malik019/iot-project/model3d/deans-t-plug-connectors-male-and-female-1.snapshot.5/ULTRA-PLUG.png

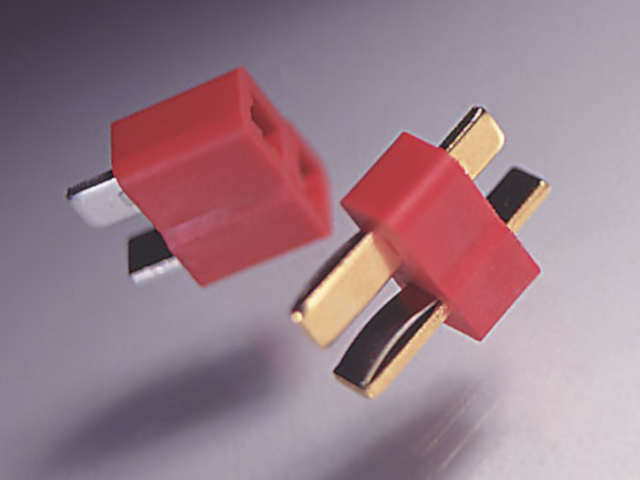
model3d/deans-t-plug-connectors-male-and-female-1.snapshot.5/ULTRA-PLUG.png
