malik019/iot-project/model3d/deans-t-plug-connectors-male-and-female-1.snapshot.5/Dins T-Plug.png

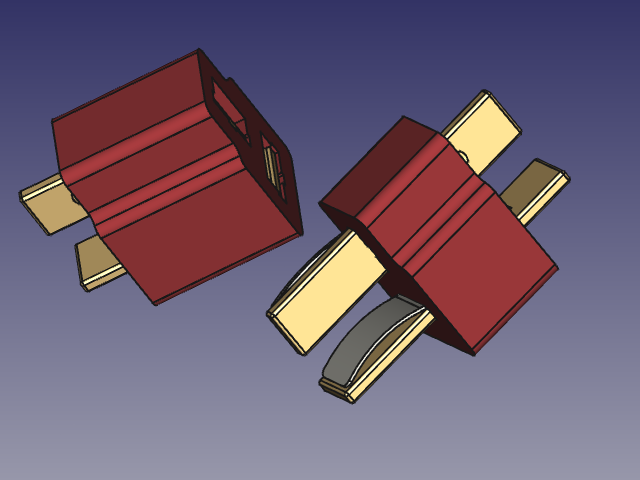
model3d/deans-t-plug-connectors-male-and-female-1.snapshot.5/Dins T-Plug.png
