malik019/iot-project/model3d/deans-t-plug-connectors-male-and-female-1.snapshot.5/T-Plug male - W.S Deans Co. Est. 1957.step

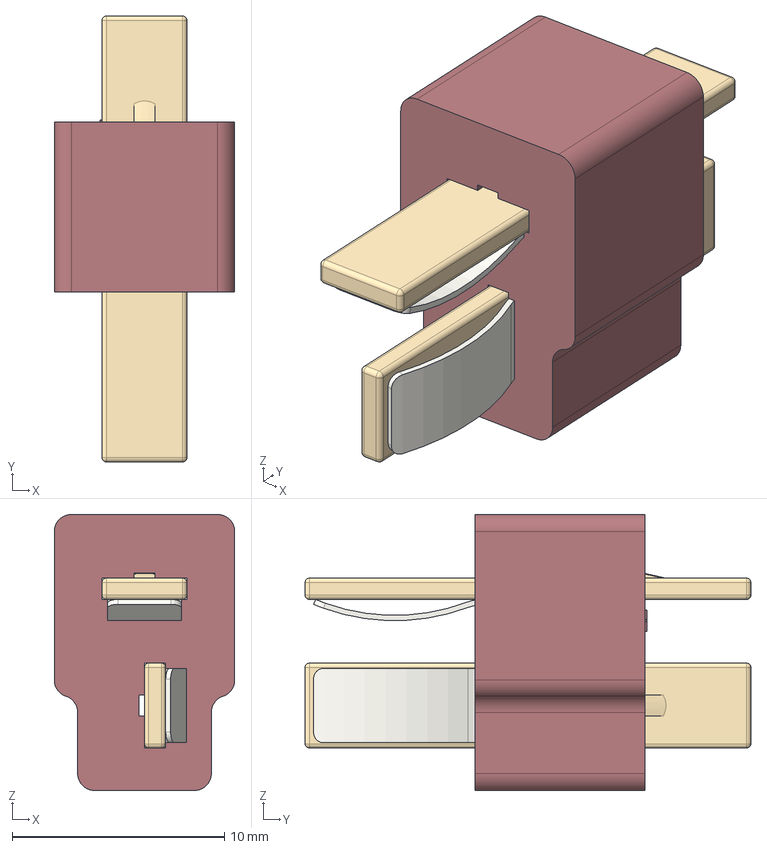
[picture p32: CAD file, 2026-05-25]
model3d/deans-t-plug-connectors-male-and-female-1.snapshot.5/T-Plug male - W.S Deans Co. Est. 1957.step
8.50 x 21.0 x 13.0 mm
