malik019/iot-project/model3d/WS2812-2020--3DModel-STEP-1.STEP

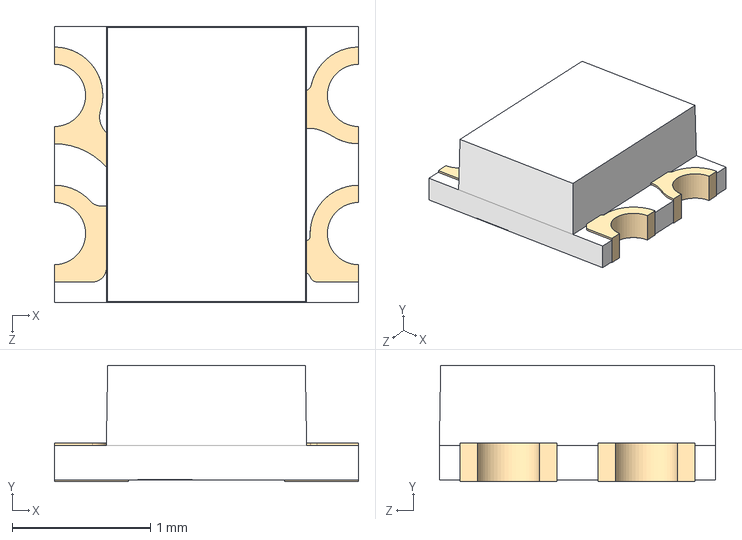
[picture p33: CAD file, 2026-05-25]
model3d/WS2812-2020--3DModel-STEP-1.STEP
2.20 x 0.84 x 2.00 mm
