malik019/iot-project/TP5100/TP5100.step

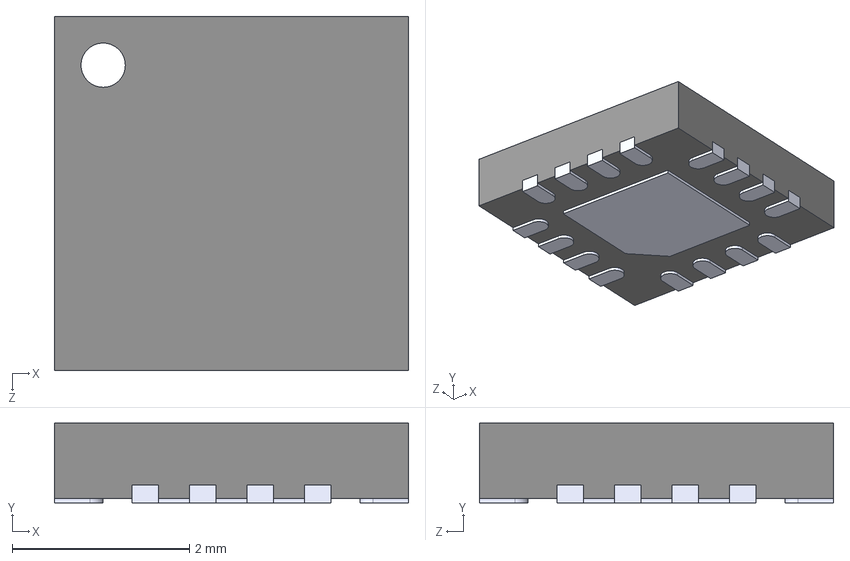
[picture p34: CAD file, 2026-05-25]
TP5100/TP5100.step
4.00 x 0.9 x 4.00 mm
