malik019/iot-project/model3d/deans-t-plug-connectors-male-and-female-1.snapshot.5/T-Plug female - W.S Deans Co. Est. 1957.step

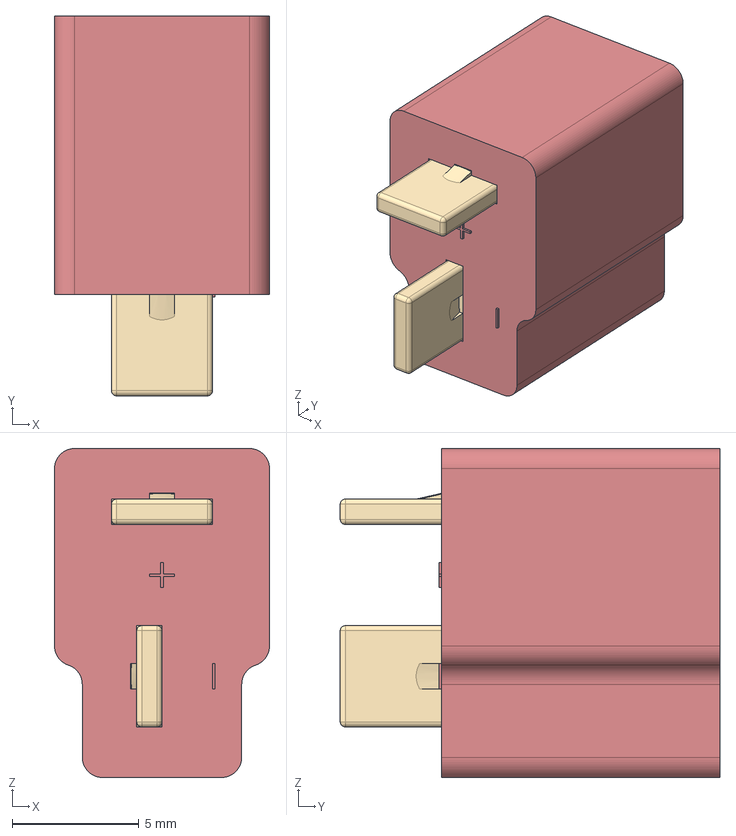
[picture p35: CAD file, 2026-05-25]
model3d/deans-t-plug-connectors-male-and-female-1.snapshot.5/T-Plug female - W.S Deans Co. Est. 1957.step
8.50 x 15.0 x 13.0 mm
