malik019/iot-project/model3d/TS-1187A-B-A-B--3DModel-STEP-56544.STEP

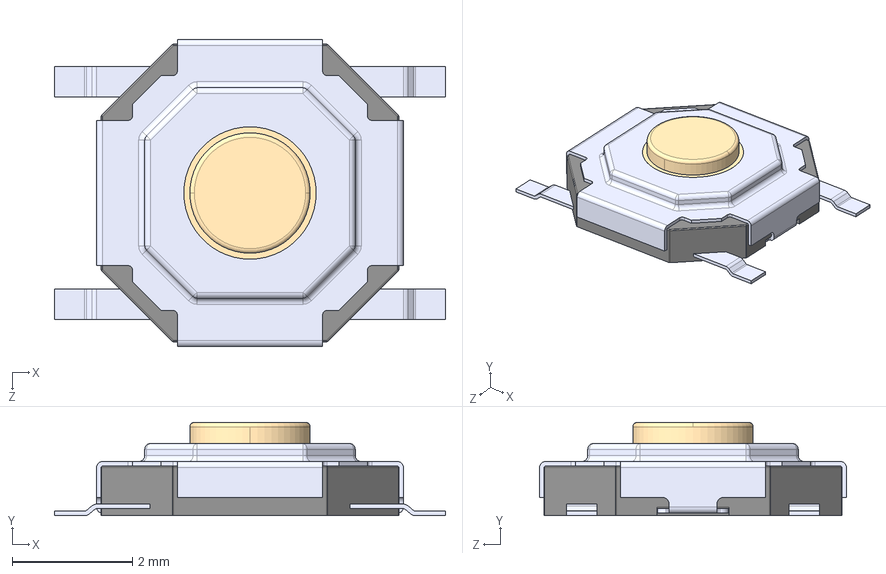
[picture p36: CAD file, 2026-05-25]
model3d/TS-1187A-B-A-B--3DModel-STEP-56544.STEP
6.50 x 1.55 x 5.10 mm
