malik019/iot-project/model3d/ESP32-C6-MINI-1-H4.STEP

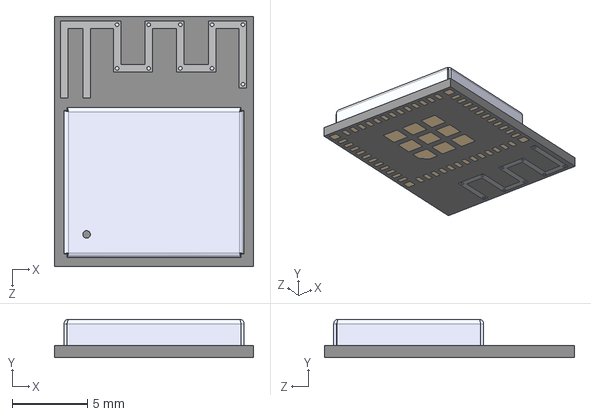
[picture p37: CAD file, 2026-05-25]
model3d/ESP32-C6-MINI-1-H4.STEP
13.2 x 2.55 x 16.6 mm
