malik019/iot-project/robot.kicad_pcb

## KiCad design robot.kicad_pcb (2026-05-28)

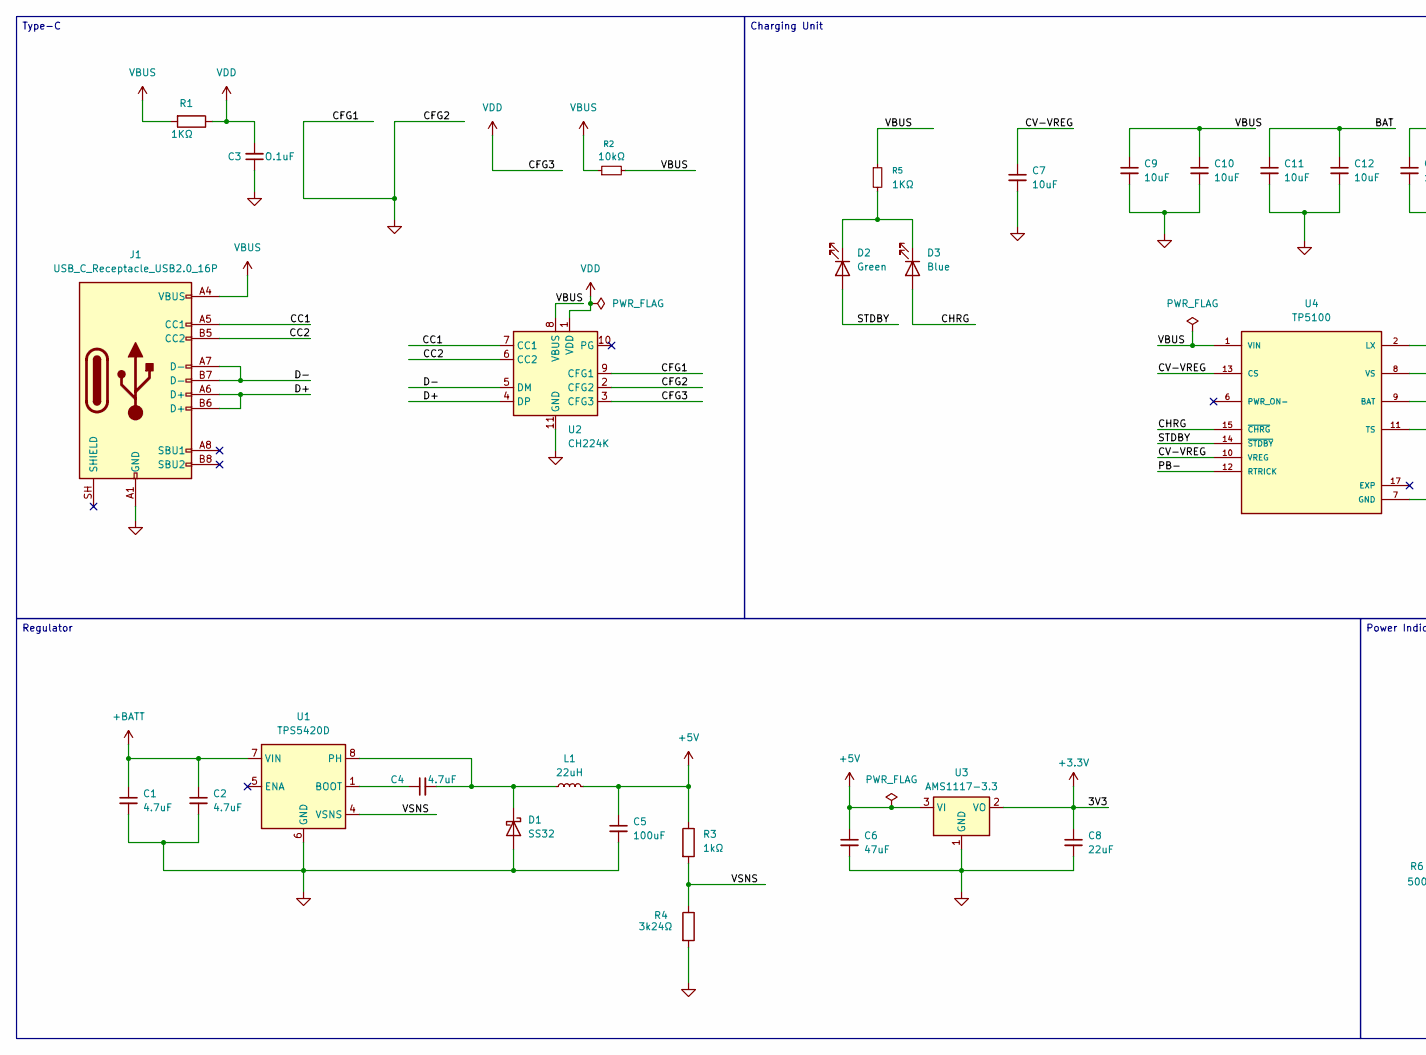
[picture p38: schematic robot.kicad_sch, Power, part in row 1, column 1]

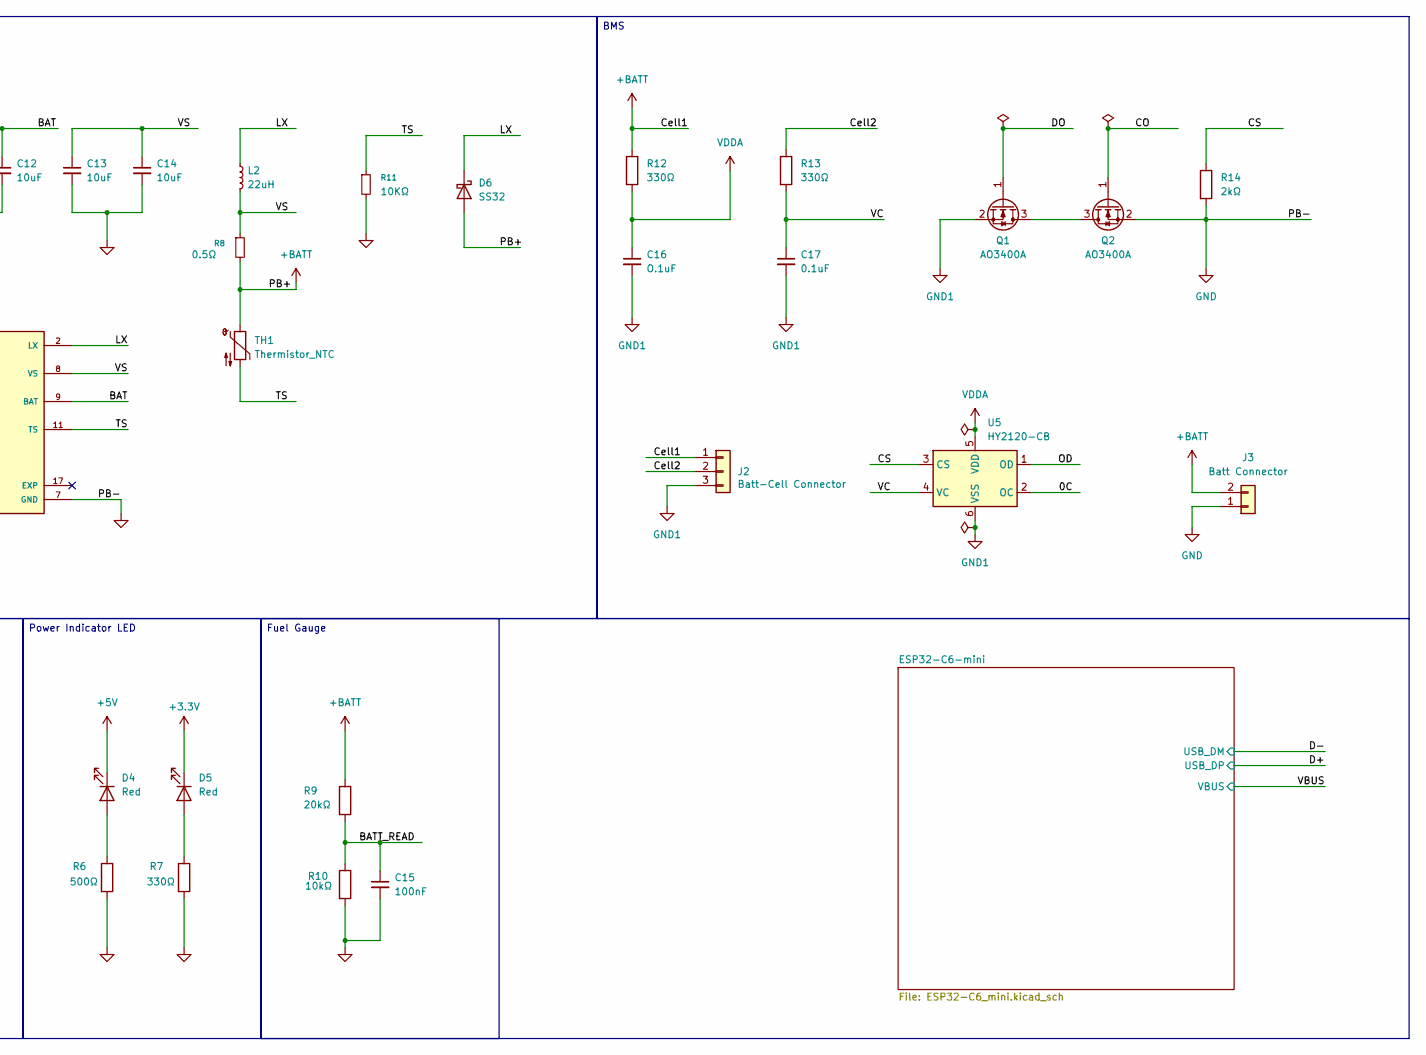
[picture p39: schematic robot.kicad_sch, Power, part in row 1, column 2]

Parts:
C1, C2, C4: 4.7uF; C_0805_2012Metric
C3, C16: O.1uF; C_0805_2012Metric
C5: 100uF; C_0805_2012Metric
C6: 47uF; C_0805_2012Metric
C7, C9, C10, C11, C12, C13, C14: 10uF; C_0805_2012Metric
C8: 22uF; C_0805_2012Metric
C15: 100nF; C_0805_2012Metric
C17: 0.1uF; C_0805_2012Metric
D1, D6: SS32; D_SMA
D2: Green; LED_0805_2012Metric
D3: Blue; LED_0805_2012Metric
D4, D5: Red; LED_0805_2012Metric
J1: USB_C_Receptacle_USB2.0_16P; USB_C_Receptacle_HRO_TYPE-C-31-M-12
J2: Batt-Cell Connector; JST_XH_B3B-XH-A_1x03_P2.50mm_Vertical
J3: Batt Connector; DEANS
L1, L2: 22uH; L_Changjiang_FXL0630
Q1, Q2: AO3400A; SOT-23
R1, R5: 1KΩ; R_0805_2012Metric
R2, R10: 10kΩ; R_0805_2012Metric
R3: 1kΩ; R_0805_2012Metric
R4: 3k24Ω; R_0805_2012Metric
R6: 500Ω; R_0805_2012Metric
R7, R12, R13: 330Ω; R_0805_2012Metric
R8: 0.5Ω; R_0805_2012Metric
R9: 20kΩ; R_0805_2012Metric
R11: 10KΩ; R_0805_2012Metric
R14: 2kΩ; R_0805_2012Metric
TH1: Thermistor_NTC; R_0805_2012Metric
U1: TPS5420D; SOIC-8_3.9x4.9mm_P1.27mm
U2: CH224K; SSOP-10-1EP_3.9x4.9mm_P1mm_EP2.1x3.3mm
U3: AMS1117-3.3; SOT-223-3_TabPin2
U4: TP5100; QFN65P400X400X90-17N; PARTREV 2.3
U5: HY2120-CB; SOT-23-6

Connections:
+3.3V: C8.1, D5.1 (K), U3.2 (VO); also elsewhere on the board
+5V: C5.1, C6.1, D4.1 (K), L1.2, R3.1, U3.3 (VI); also elsewhere on the board
+BATT: C1.1, C2.1, D6.2 (A), J2.1, J3.2, R8.2, R9.1, R12.1, TH1.1, U1.7 (VIN); also elsewhere on the board
/0C: U5.2 (OC)
/BAT: C11.1, C12.1, U4.9 (BAT)
/BATT_READ: C15.1, R9.2, R10.1
/CC1: J1.A5 (CC1), U2.7 (CC1)
/CC2: J1.B5 (CC2), U2.6 (CC2)
/CHRG: D3.2 (A), U4.15 (~CHRG)
/CO: Q2.1 (G)
/CS: R14.1, U5.3 (CS)
/CV-VREG: C7.1, U4.10 (VREG), U4.13 (CS)
/Cell2: J2.2, R13.1
/D+: J1.A6 (D+), J1.B6 (D+), U2.4 (DP); also elsewhere on the board
/D-: J1.A7 (D-), J1.B7 (D-), U2.5 (DM); also elsewhere on the board
/DO: Q1.1 (G)
/LX: D6.1 (K), L2.1, U4.2 (LX), U4.3 (LX)
/OD: U5.1 (OD)
/STDBY: D2.2 (A), U4.14 (~STDBY)
/TS: R11.1, TH1.2, U4.11 (TS)
/VC: C17.1, R13.2, U5.4 (VC)
/VS: C13.1, C14.1, L2.2, R8.1, U4.8 (VS)
/VSNS: R3.2, R4.1, U1.4 (VSNS)
GND: C1.2, C2.2, C3.1, C5.2, C6.2, C7.2, C8.2, C9.2, C10.2, C11.2, C12.2, C13.2, C14.2, C15.2, D1.2 (A), J1.A1 (GND), J1.A12 (GND), J1.B1 (GND), J1.B12 (GND), J3.1, Q2.2 (S), R4.2, R6.2, R7.2, R10.2, R11.2, R14.2, U1.6 (GND), U2.2 (CFG2), U2.9 (CFG1), U2.11 (GND), U3.1 (GND), U4.7 (GND), U4.12 (RTRICK); also elsewhere on the board
GND1: C16.2, C17.2, J2.3, Q1.2 (S), U5.6 (VSS)
unnamed: C4.2, D1.1 (K), L1.1, U1.8 (PH)
unnamed: D2.1 (K), D3.1 (K), R5.2
unnamed: D4.2 (A), R6.1
unnamed: D5.2 (A), R7.1
unnamed: Q1.3 (D), Q2.3 (D)
unnamed: C4.1, U1.1 (BOOT)
VBUS: C9.1, C10.1, J1.A4 (VBUS), J1.A9 (VBUS), J1.B4 (VBUS), J1.B9 (VBUS), R1.2, R2.1, R2.2, R5.1, U2.8 (VBUS), U4.1 (VIN), U4.4 (VIN), U4.5 (VIN), U4.16 (VIN); also elsewhere on the board
VDD: C3.2, R1.1, U2.1 (VDD), U2.3 (CFG3)
VDDA: C16.1, R12.2, U5.5 (VDD)

Notes on the sheet:
Charging Unit
Type-C
BMS
Fuel Gauge
Power Indicator LED
Regulator

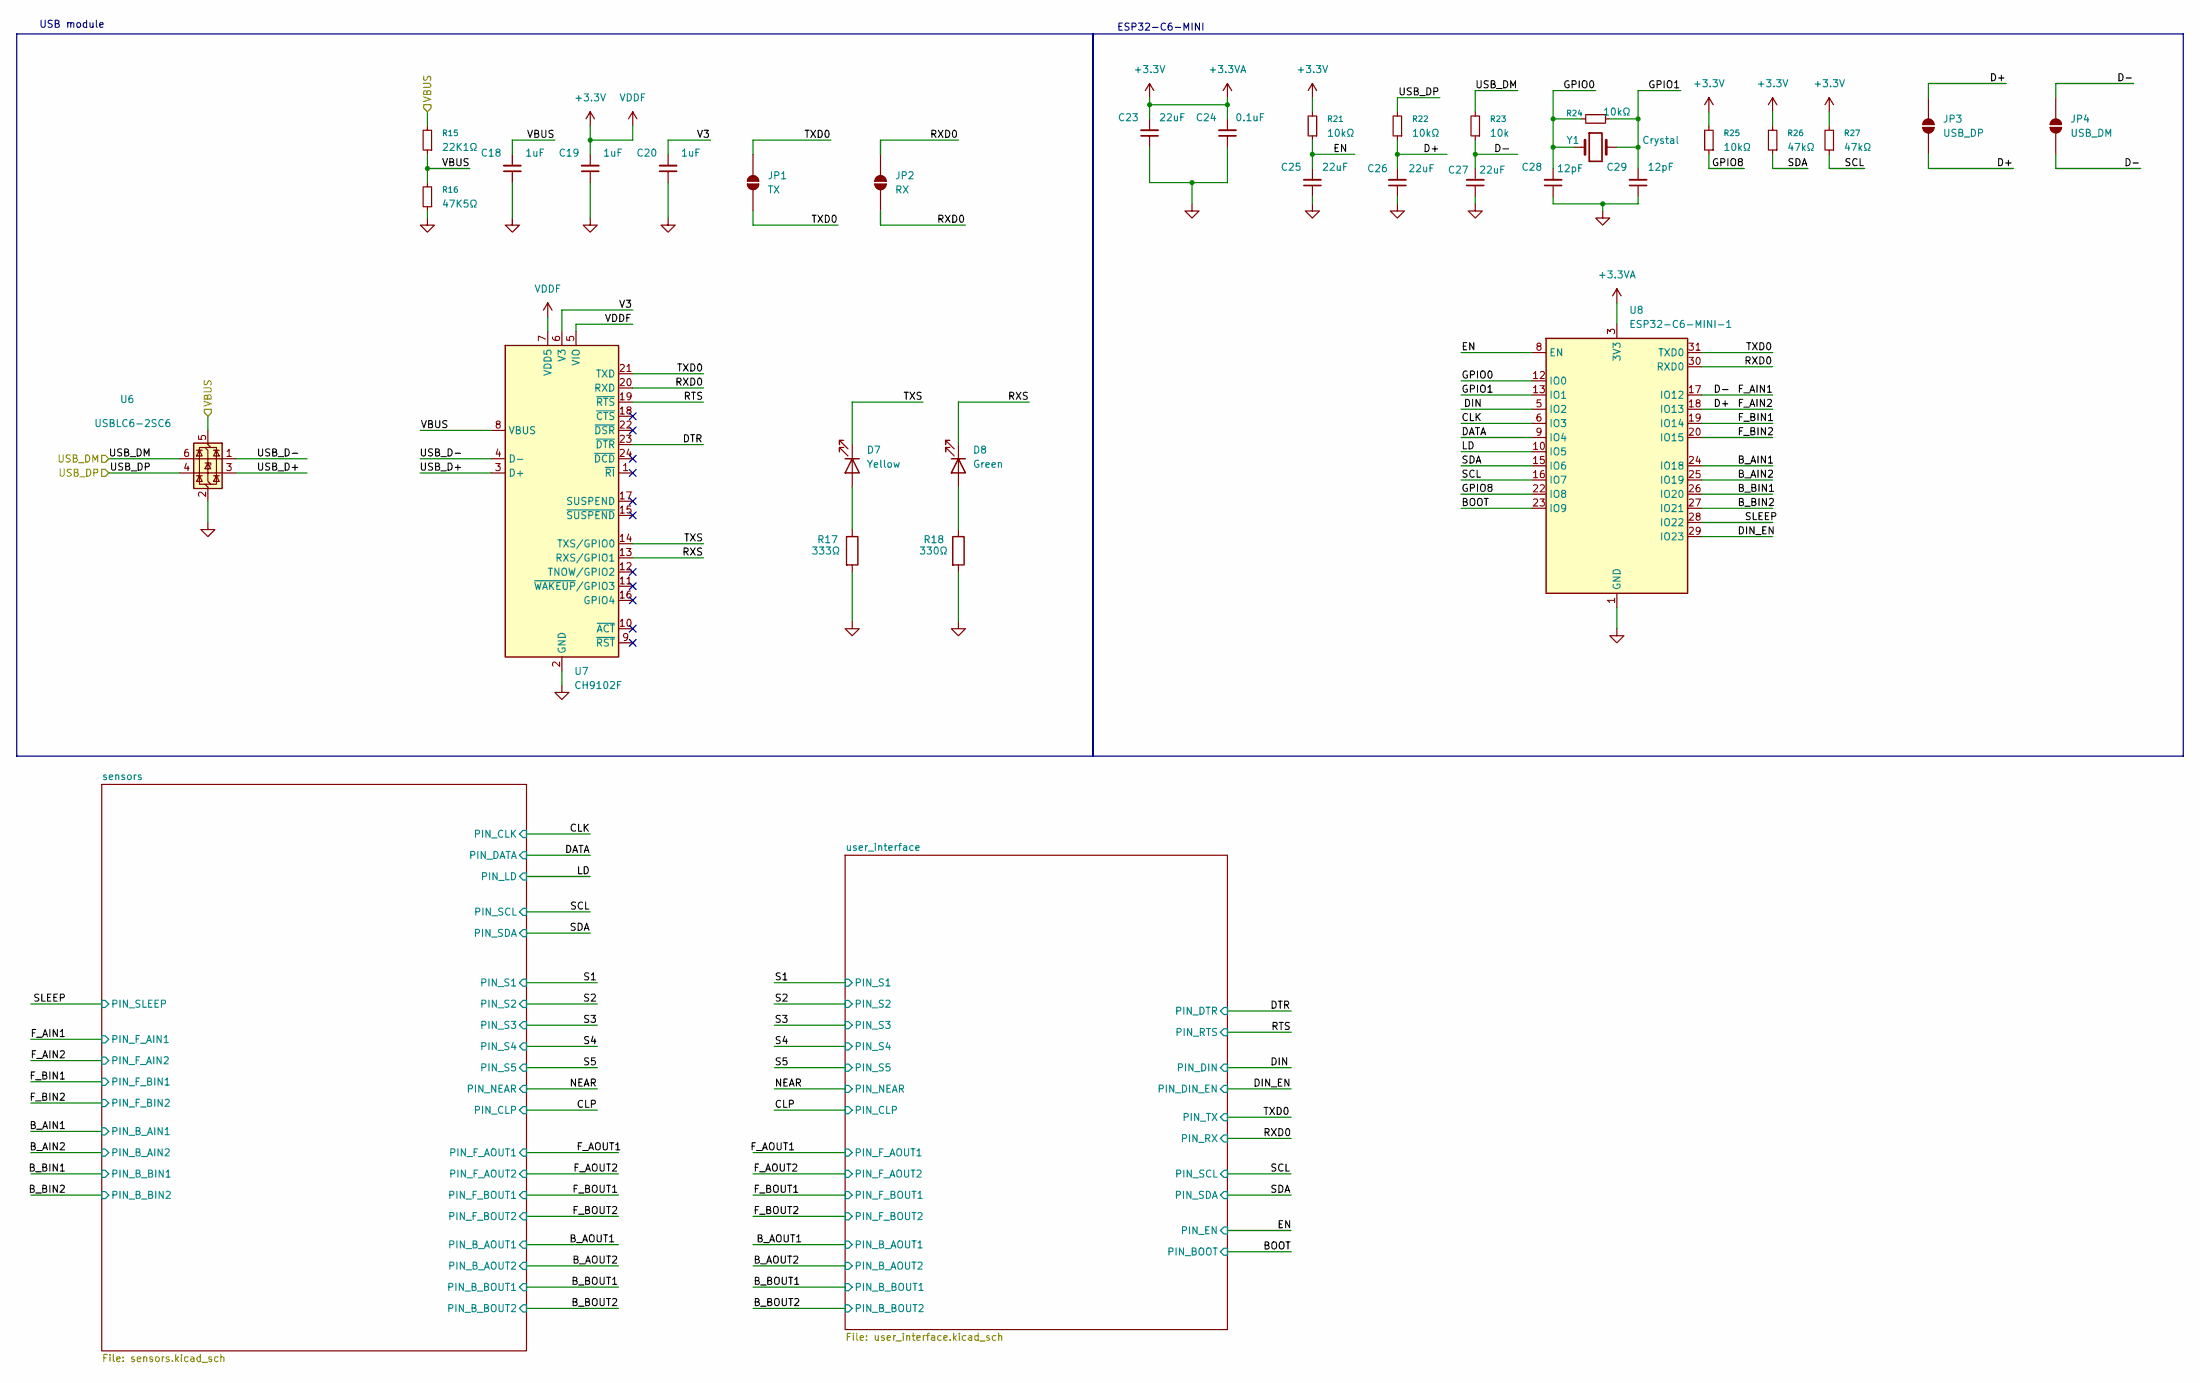
[picture p40: schematic ESP32-C6_mini.kicad_sch, ESP32-C6-MINI]

Parts:
C18, C19, C20: 1uF; C_0805_2012Metric
C23, C25, C26, C27: 22uF; C_0805_2012Metric
C24: 0.1uF; C_0805_2012Metric
C28, C29: 12pF; C_0805_2012Metric
D7: Yellow; LED_0805_2012Metric
D8: Green; LED_0805_2012Metric
JP1: TX; SolderJumper-2_P1.3mm_Open_TrianglePad1.0x1.5mm
JP2: RX; SolderJumper-2_P1.3mm_Open_TrianglePad1.0x1.5mm
JP3: USB_DP; SolderJumper-2_P1.3mm_Open_TrianglePad1.0x1.5mm
JP4: USB_DM; SolderJumper-2_P1.3mm_Open_TrianglePad1.0x1.5mm
R15: 22K1Ω; R_0805_2012Metric
R16: 47K5Ω; R_0805_2012Metric
R17: 333Ω; R_0805_2012Metric
R18: 330Ω; R_0805_2012Metric
R21, R22, R24, R25: 10kΩ; R_0805_2012Metric
R23: 10k; R_0805_2012Metric
R26, R27: 47kΩ; R_0805_2012Metric
U6: USBLC6-2SC6; SOT-23-6
U7: CH9102F; QFN-24-1EP_4x4mm_P0.5mm_EP2.6x2.6mm
U8: ESP32-C6-MINI-1
Y1: Crystal; Crystal_SMD_3215-2Pin_3.2x1.5mm

Connections:
+3.3V: C19.2, C23.2, C24.2, R21.2, R25.2, R26.2, R27.2, U7.5 (VIO), U7.7 (VDD5), U8.3 (3V3); also elsewhere on the board
/D+: R22.2, U6.4 (I/O2); also elsewhere on the board
/D-: R23.2, U6.6 (I/O1); also elsewhere on the board
/ESP32-C6-mini/BOOT: U8.23 (IO9); also elsewhere on the board
/ESP32-C6-mini/B_AIN1: U8.24 (IO18); also elsewhere on the board
/ESP32-C6-mini/B_AIN2: U8.25 (IO19); also elsewhere on the board
/ESP32-C6-mini/B_BIN1: U8.26 (IO20); also elsewhere on the board
/ESP32-C6-mini/B_BIN2: U8.27 (IO21); also elsewhere on the board
/ESP32-C6-mini/CLK: U8.6 (IO3); also elsewhere on the board
/ESP32-C6-mini/D+: C26.2, JP3.1 (A), JP3.2 (B), R22.1, U8.18 (IO13); also elsewhere on the board
/ESP32-C6-mini/D-: C27.2, JP4.1 (A), JP4.2 (B), R23.1, U8.17 (IO12); also elsewhere on the board
/ESP32-C6-mini/DATA: U8.9 (IO4); also elsewhere on the board
/ESP32-C6-mini/DIN: U8.5 (IO2); also elsewhere on the board
/ESP32-C6-mini/DIN_EN: U8.29 (IO23); also elsewhere on the board
/ESP32-C6-mini/DTR: U7.23 (~DTR); also elsewhere on the board
/ESP32-C6-mini/EN: C25.2, R21.1, U8.8 (EN); also elsewhere on the board
/ESP32-C6-mini/F_BIN1: U8.19 (IO14); also elsewhere on the board
/ESP32-C6-mini/F_BIN2: U8.20 (IO15); also elsewhere on the board
/ESP32-C6-mini/GPIO0: C28.2, R24.2, U8.12 (IO0), Y1.1
/ESP32-C6-mini/GPIO1: C29.2, R24.1, U8.13 (IO1), Y1.2
/ESP32-C6-mini/GPIO8: R25.1, U8.22 (IO8)
/ESP32-C6-mini/LD: U8.10 (IO5); also elsewhere on the board
/ESP32-C6-mini/RTS: U7.19 (~RTS); also elsewhere on the board
/ESP32-C6-mini/RXD0: JP2.1 (A), JP2.2 (B), U7.20 (RXD), U8.30 (RXD0); also elsewhere on the board
/ESP32-C6-mini/RXS: D8.1 (K), U7.13 (RXS/GPIO1)
/ESP32-C6-mini/SCL: R27.1, U8.16 (IO7); also elsewhere on the board
/ESP32-C6-mini/SDA: R26.1, U8.15 (IO6); also elsewhere on the board
/ESP32-C6-mini/SLEEP: U8.28 (IO22); also elsewhere on the board
/ESP32-C6-mini/TXD0: JP1.1 (A), JP1.2 (B), U7.21 (TXD), U8.31 (TXD0); also elsewhere on the board
/ESP32-C6-mini/TXS: D7.1 (K), U7.14 (TXS/GPIO0)
/ESP32-C6-mini/USB_D+: U6.3 (I/O2), U7.3 (D+)
/ESP32-C6-mini/USB_D-: U6.1 (I/O1), U7.4 (D-)
/ESP32-C6-mini/V3: C20.2, U7.6 (V3)
GND: C18.1, C19.1, C20.1, C23.1, C24.1, C25.1, C26.1, C27.1, C28.1, C29.1, R16.1, R17.2, R18.2, U6.2 (GND), U7.2 (GND), U7.25 (GND), U8.1 (GND), U8.2 (GND), U8.11 (GND), U8.14 (GND), U8.36 (GND), U8.37 (GND), U8.38 (GND), U8.39 (GND), U8.40 (GND), U8.41 (GND), U8.42 (GND), U8.43 (GND), U8.44 (GND), U8.45 (GND), U8.46 (GND), U8.47 (GND), U8.48 (GND), U8.49 (GND), U8.50 (GND), U8.51 (GND), U8.52 (GND), U8.53 (GND); also elsewhere on the board
unnamed: D7.2 (A), R17.1
unnamed: D8.2 (A), R18.1
VBUS: C18.2, R15.1, R15.2, R16.2, U6.5 (VBUS), U7.8 (VBUS); also elsewhere on the board

Notes on the sheet:
USB module
ESP32-C6-MINI

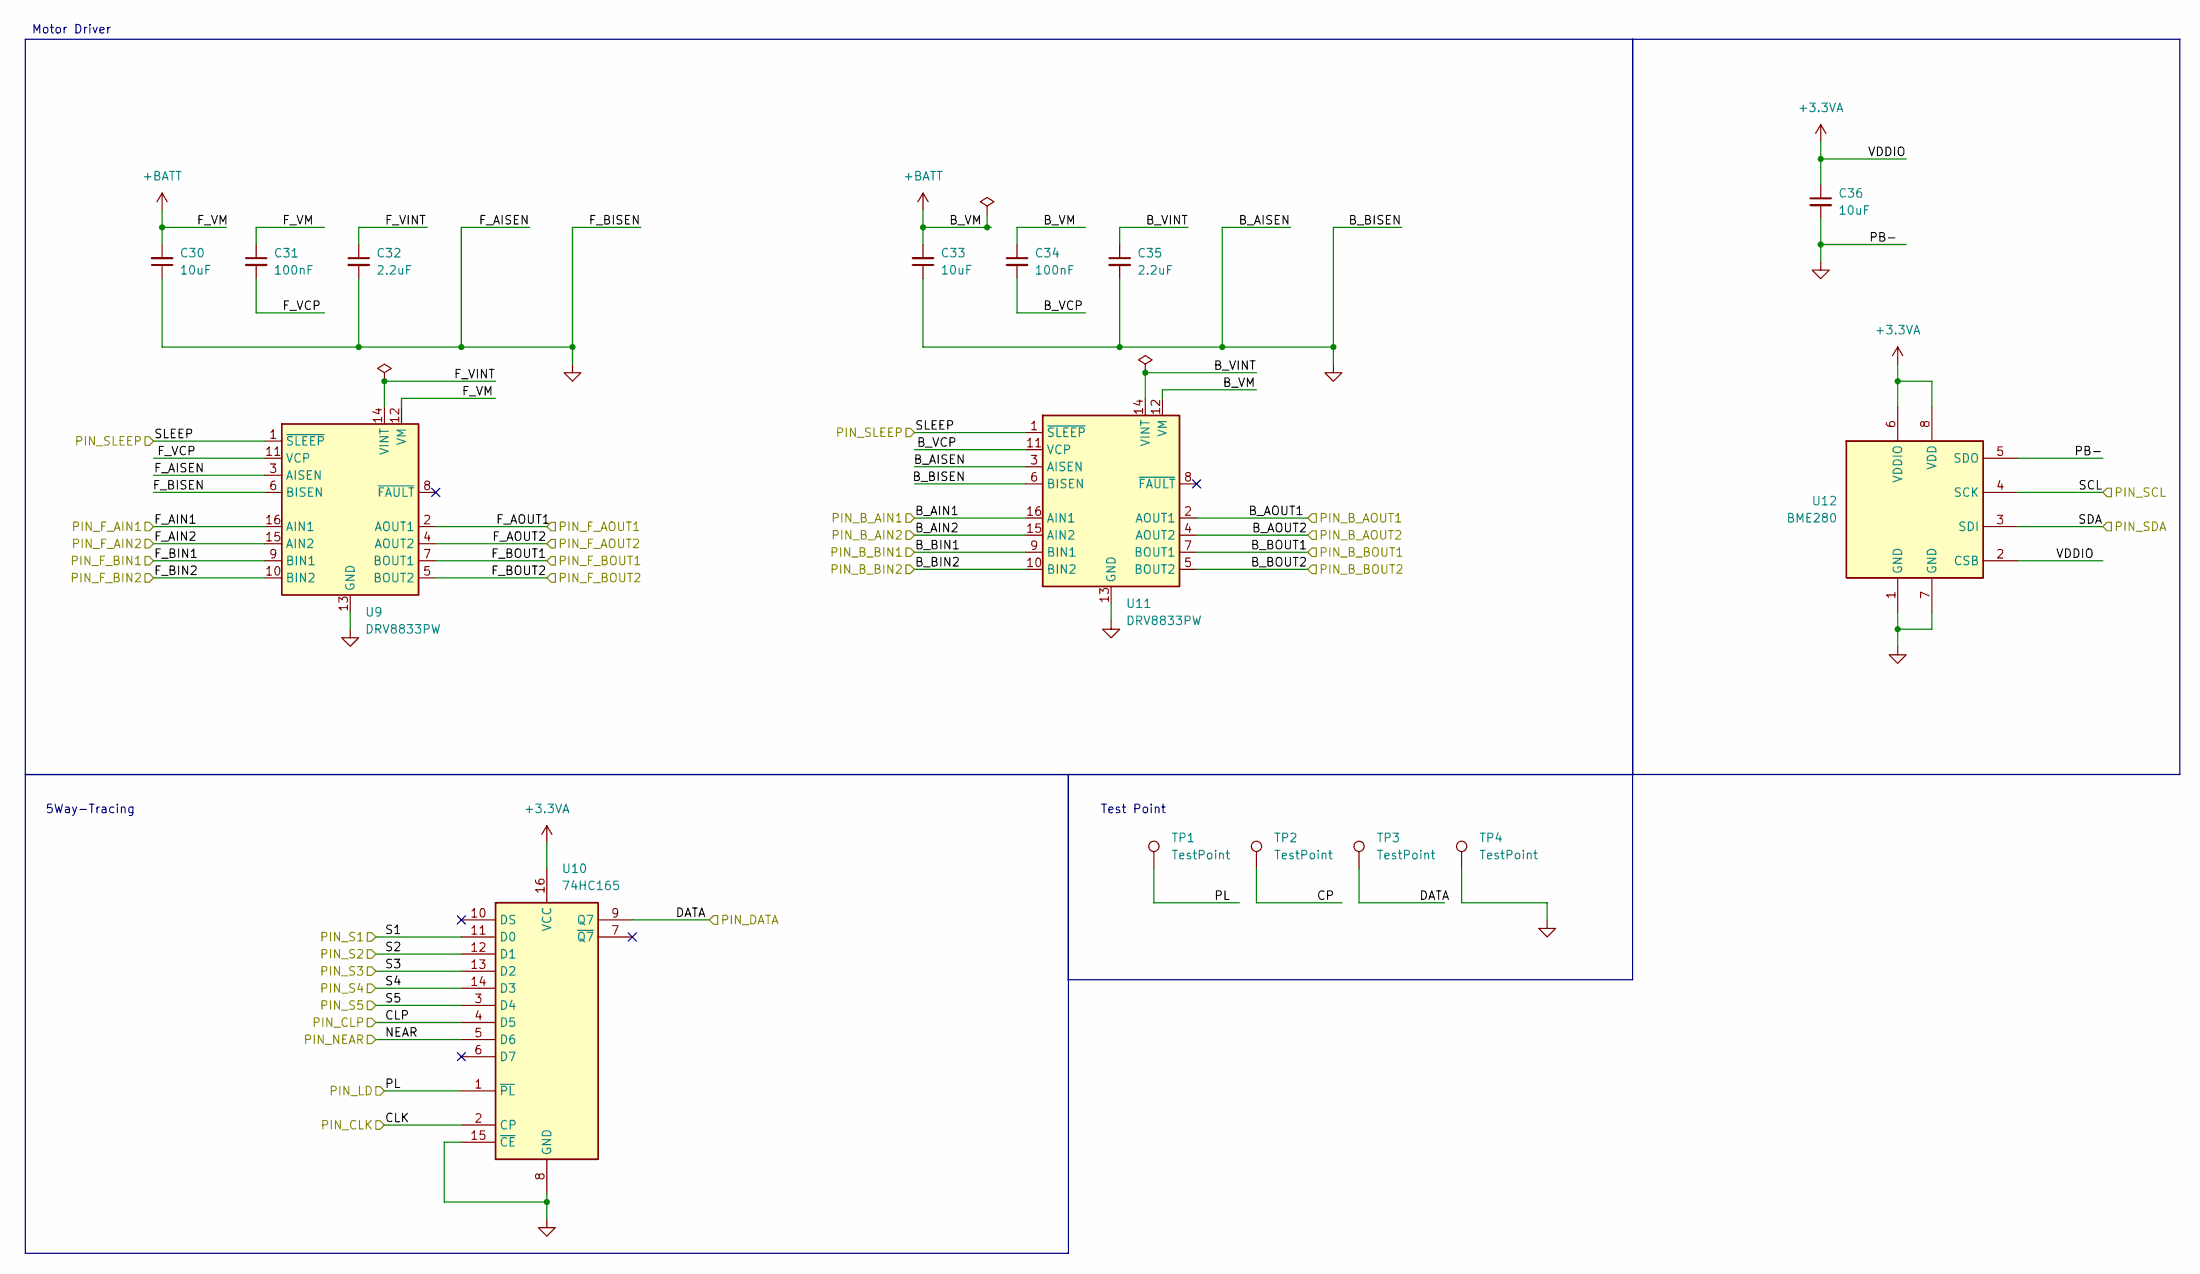
[picture p41: schematic sensors.kicad_sch, Actuators & Sensors]

Parts:
C30, C33, C36: 10uF; C_0805_2012Metric
C31, C34: 100nF; C_0805_2012Metric
C32, C35: 2.2uF; C_0805_2012Metric
TP1, TP2, TP3, TP4: TestPoint; TestPoint_Pad_D2.5mm
U9, U11: DRV8833PW; TSSOP-16_4.4x5mm_P0.65mm
U10: 74HC165; SO-16_3.9x9.9mm_P1.27mm
U12: BME280; Bosch_LGA-8_2.5x2.5mm_P0.65mm_ClockwisePinNumbering

Connections:
+3.3V: C36.1, U10.16 (VCC), U12.2 (CSB), U12.6 (VDDIO), U12.8 (VDD); also elsewhere on the board
+BATT: C30.2, C31.1, C33.2, C34.1, U9.12 (VM), U11.12 (VM); also elsewhere on the board
/ESP32-C6-mini/B_AIN1: U11.16 (AIN1); also elsewhere on the board
/ESP32-C6-mini/B_AIN2: U11.15 (AIN2); also elsewhere on the board
/ESP32-C6-mini/B_AOUT1: U11.2 (AOUT1); also elsewhere on the board
/ESP32-C6-mini/B_AOUT2: U11.4 (AOUT2); also elsewhere on the board
/ESP32-C6-mini/B_BIN1: U11.9 (BIN1); also elsewhere on the board
/ESP32-C6-mini/B_BIN2: U11.10 (BIN2); also elsewhere on the board
/ESP32-C6-mini/B_BOUT1: U11.7 (BOUT1); also elsewhere on the board
/ESP32-C6-mini/B_BOUT2: U11.5 (BOUT2); also elsewhere on the board
/ESP32-C6-mini/CLK: U10.2 (CP); also elsewhere on the board
/ESP32-C6-mini/CLP: U10.4 (D5); also elsewhere on the board
/ESP32-C6-mini/D+: U9.15 (AIN2); also elsewhere on the board
/ESP32-C6-mini/D-: U9.16 (AIN1); also elsewhere on the board
/ESP32-C6-mini/DATA: TP3.1 (1_1), U10.9 (Q7); also elsewhere on the board
/ESP32-C6-mini/F_AOUT1: U9.2 (AOUT1); also elsewhere on the board
/ESP32-C6-mini/F_AOUT2: U9.4 (AOUT2); also elsewhere on the board
/ESP32-C6-mini/F_BIN1: U9.9 (BIN1); also elsewhere on the board
/ESP32-C6-mini/F_BIN2: U9.10 (BIN2); also elsewhere on the board
/ESP32-C6-mini/F_BOUT1: U9.7 (BOUT1); also elsewhere on the board
/ESP32-C6-mini/F_BOUT2: U9.5 (BOUT2); also elsewhere on the board
/ESP32-C6-mini/LD: TP1.1 (1_1), U10.1 (~PL); also elsewhere on the board
/ESP32-C6-mini/NEAR: U10.5 (D6); also elsewhere on the board
/ESP32-C6-mini/S1: U10.11 (D0); also elsewhere on the board
/ESP32-C6-mini/S2: U10.12 (D1); also elsewhere on the board
/ESP32-C6-mini/S3: U10.13 (D2); also elsewhere on the board
/ESP32-C6-mini/S4: U10.14 (D3); also elsewhere on the board
/ESP32-C6-mini/S5: U10.3 (D4); also elsewhere on the board
/ESP32-C6-mini/SCL: U12.4 (SCK); also elsewhere on the board
/ESP32-C6-mini/SDA: U12.3 (SDI); also elsewhere on the board
/ESP32-C6-mini/SLEEP: U9.1 (~SLEEP), U11.1 (~SLEEP); also elsewhere on the board
/ESP32-C6-mini/sensors/B_VCP: C34.2, U11.11 (VCP)
/ESP32-C6-mini/sensors/B_VINT: C35.1, U11.14 (VINT)
/ESP32-C6-mini/sensors/CP: TP2.1 (1_1)
/ESP32-C6-mini/sensors/F_VCP: C31.2, U9.11 (VCP)
/ESP32-C6-mini/sensors/F_VINT: C32.1, U9.14 (VINT)
GND: C30.1, C32.2, C33.1, C35.2, C36.2, TP4.1 (1_1), U9.3 (AISEN), U9.6 (BISEN), U9.13 (GND), U10.8 (GND), U10.15 (~CE), U11.3 (AISEN), U11.6 (BISEN), U11.13 (GND), U12.1 (GND), U12.5 (SDO), U12.7 (GND); also elsewhere on the board

Notes on the sheet:
5Way-Tracing
Motor Driver
Test Point

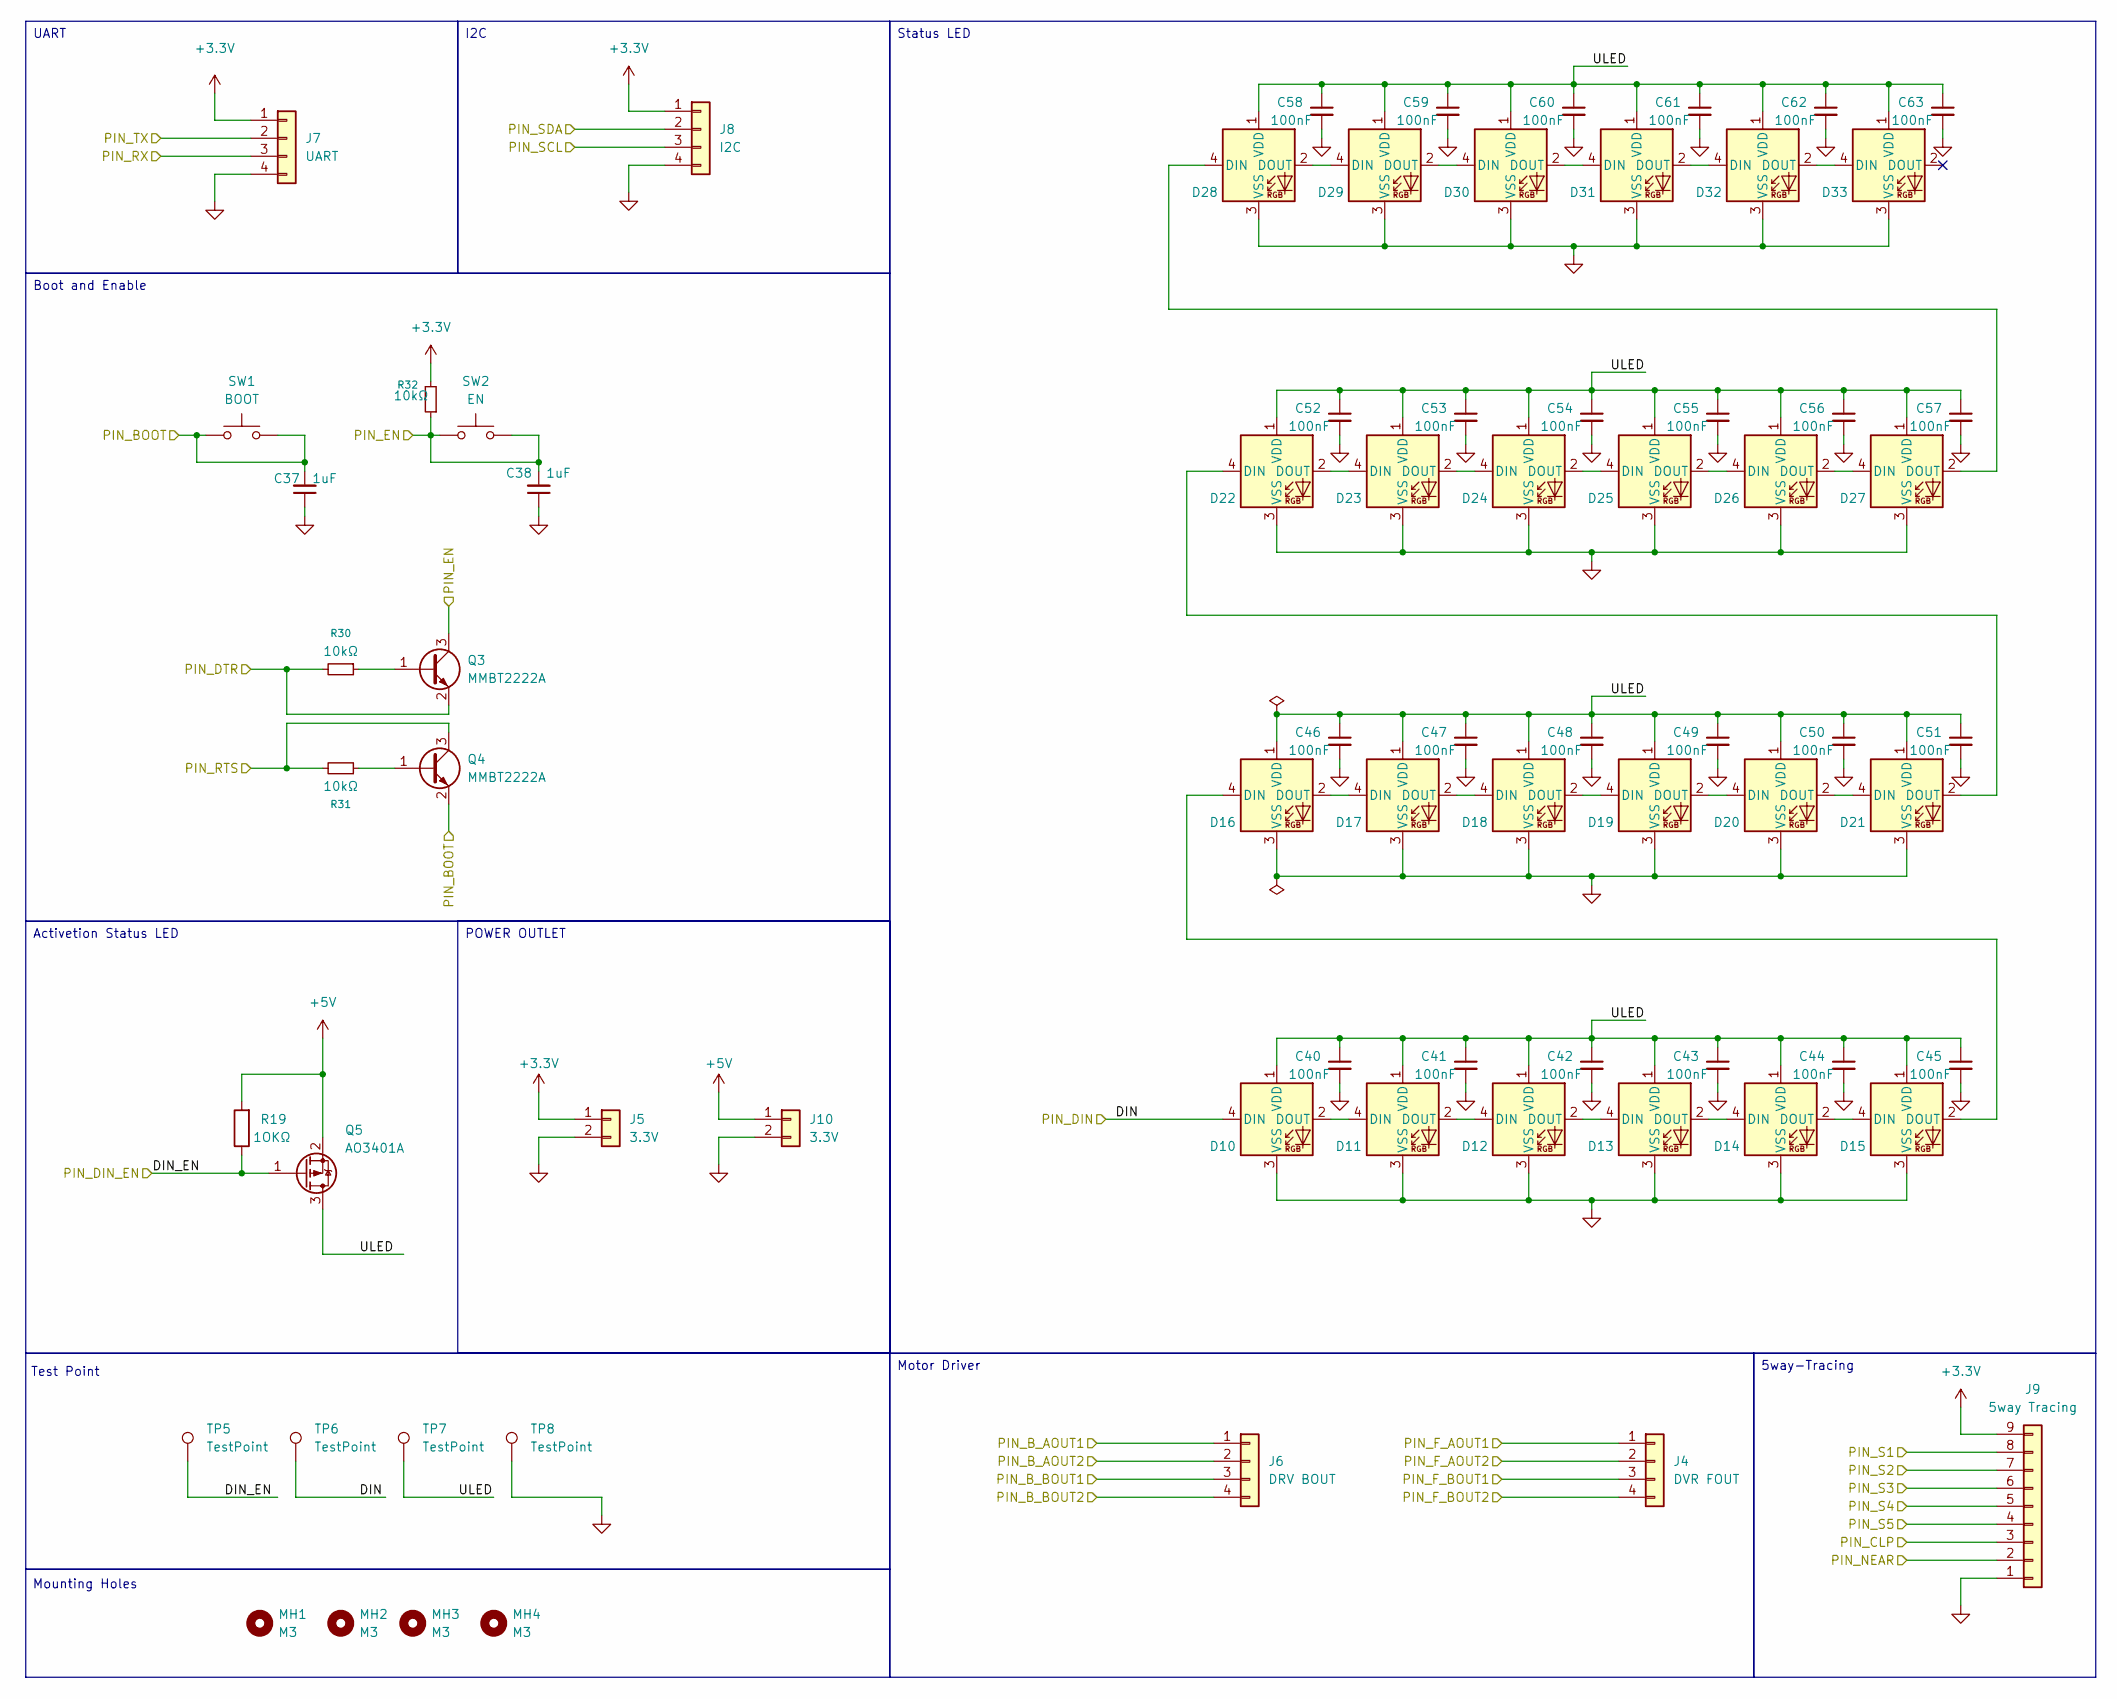
[picture p42: schematic user_interface.kicad_sch, Actuators]

Parts:
C37, C38: 1uF; C_0805_2012Metric
C40, C41, C42, C43, C44, C45, C46, C47, C48, C49, C50, C51, C52, C53, C54, C55, C56, C57, C58, C59, C60, C61, C62, C63: 100nF; C_0402_1005Metric
D10, D11, D12, D13, D14, D15, D16, D17, D18, D19, D20, D21, D22, D23, D24, D25, D26, D27, D28, D29, D30, D31, D32, D33: WS2812B; LED_WS2812B-2020_PLCC4_2.0x2.0mm
J4: DVR FOUT; TerminalBlock_Phoenix_MKDS-1,5-4-5.08_1x04_P5.08mm_Horizont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
J5, J10: 3.3V
J6: DRV BOUT; TerminalBlock_Phoenix_MKDS-1,5-4-5.08_1x04_P5.08mm_Horizont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
J7: UART; PinHeader_1x04_P2.54mm_Vertical
J8: I2C; PinHeader_1x04_P2.54mm_Vertical
J9: 5way Tracing; PinHeader_1x09_P2.54mm_Vertical
MH1, MH2, MH3, MH4: M3; MountingHole_3.2mm_M3
Q3, Q4: MMBT2222A; SOT-23
Q5: AO3401A; SOT-23
R19: 1OKΩ; R_0805_2012Metric
R30, R31, R32: 10kΩ; R_0805_2012Metric
SW1: BOOT; SW_Push_1P1T_XKB_TS-1187A
SW2: EN; SW_Push_1P1T_XKB_TS-1187A
TP5, TP6, TP7, TP8: TestPoint; TestPoint_Pad_D2.5mm

Connections:
+3.3V: J5.1, J7.1, J8.1, J9.9, R32.2; also elsewhere on the board
+5V: J10.1, Q5.2 (S), R19.2; also elsewhere on the board
/ESP32-C6-mini/BOOT: C37.2, Q4.2 (E), SW1.1, SW1.2; also elsewhere on the board
/ESP32-C6-mini/B_AOUT1: J6.1; also elsewhere on the board
/ESP32-C6-mini/B_AOUT2: J6.2; also elsewhere on the board
/ESP32-C6-mini/B_BOUT1: J6.3; also elsewhere on the board
/ESP32-C6-mini/B_BOUT2: J6.4; also elsewhere on the board
/ESP32-C6-mini/CLP: J9.3; also elsewhere on the board
/ESP32-C6-mini/DIN: D10.4 (DIN), TP6.1 (1_1); also elsewhere on the board
/ESP32-C6-mini/DIN_EN: Q5.1 (G), R19.1, TP5.1 (1_1); also elsewhere on the board
/ESP32-C6-mini/DTR: Q3.2 (E), R30.2; also elsewhere on the board
/ESP32-C6-mini/EN: C38.2, Q3.3 (C), R32.1, SW2.1, SW2.2; also elsewhere on the board
/ESP32-C6-mini/F_AOUT1: J4.1; also elsewhere on the board
/ESP32-C6-mini/F_AOUT2: J4.2; also elsewhere on the board
/ESP32-C6-mini/F_BOUT1: J4.3; also elsewhere on the board
/ESP32-C6-mini/F_BOUT2: J4.4; also elsewhere on the board
/ESP32-C6-mini/NEAR: J9.2; also elsewhere on the board
/ESP32-C6-mini/RTS: Q4.3 (C), R31.2; also elsewhere on the board
/ESP32-C6-mini/RXD0: J7.3; also elsewhere on the board
/ESP32-C6-mini/S1: J9.8; also elsewhere on the board
/ESP32-C6-mini/S2: J9.7; also elsewhere on the board
/ESP32-C6-mini/S3: J9.6; also elsewhere on the board
/ESP32-C6-mini/S4: J9.5; also elsewhere on the board
/ESP32-C6-mini/S5: J9.4; also elsewhere on the board
/ESP32-C6-mini/SCL: J8.3; also elsewhere on the board
/ESP32-C6-mini/SDA: J8.2; also elsewhere on the board
/ESP32-C6-mini/TXD0: J7.2; also elsewhere on the board
/ESP32-C6-mini/user_interface/ULED: C40.1, C41.1, C42.1, C43.1, C44.1, C45.1, C46.1, C47.1, C48.1, C49.1, C50.1, C51.1, C52.1, C53.1, C54.1, C55.1, C56.1, C57.1, C58.1, C59.1, C60.1, C61.1, C62.1, C63.1, D10.1 (VDD), D11.1 (VDD), D12.1 (VDD), D13.1 (VDD), D14.1 (VDD), D15.1 (VDD), D16.1 (VDD), D17.1 (VDD), D18.1 (VDD), D19.1 (VDD), D20.1 (VDD), D21.1 (VDD), D22.1 (VDD), D23.1 (VDD), D24.1 (VDD), D25.1 (VDD), D26.1 (VDD), D27.1 (VDD), D28.1 (VDD), D29.1 (VDD), D30.1 (VDD), D31.1 (VDD), D32.1 (VDD), D33.1 (VDD), Q5.3 (D), TP7.1 (1_1)
GND: C37.1, C38.1, C40.2, C41.2, C42.2, C43.2, C44.2, C45.2, C46.2, C47.2, C48.2, C49.2, C50.2, C51.2, C52.2, C53.2, C54.2, C55.2, C56.2, C57.2, C58.2, C59.2, C60.2, C61.2, C62.2, C63.2, D10.3 (VSS), D11.3 (VSS), D12.3 (VSS), D13.3 (VSS), D14.3 (VSS), D15.3 (VSS), D16.3 (VSS), D17.3 (VSS), D18.3 (VSS), D19.3 (VSS), D20.3 (VSS), D21.3 (VSS), D22.3 (VSS), D23.3 (VSS), D24.3 (VSS), D25.3 (VSS), D26.3 (VSS), D27.3 (VSS), D28.3 (VSS), D29.3 (VSS), D30.3 (VSS), D31.3 (VSS), D32.3 (VSS), D33.3 (VSS), J5.2, J7.4, J8.4, J9.1, J10.2, TP8.1 (1_1); also elsewhere on the board
unnamed: D10.2 (DOUT), D11.4 (DIN)
unnamed: D11.2 (DOUT), D12.4 (DIN)
unnamed: D12.2 (DOUT), D13.4 (DIN)
unnamed: D13.2 (DOUT), D14.4 (DIN)
unnamed: D14.2 (DOUT), D15.4 (DIN)
unnamed: D15.2 (DOUT), D16.4 (DIN)
unnamed: D16.2 (DOUT), D17.4 (DIN)
unnamed: D17.2 (DOUT), D18.4 (DIN)
unnamed: D18.2 (DOUT), D19.4 (DIN)
unnamed: D19.2 (DOUT), D20.4 (DIN)
unnamed: D20.2 (DOUT), D21.4 (DIN)
unnamed: D21.2 (DOUT), D22.4 (DIN)
unnamed: D22.2 (DOUT), D23.4 (DIN)
unnamed: D23.2 (DOUT), D24.4 (DIN)
unnamed: D24.2 (DOUT), D25.4 (DIN)
unnamed: D25.2 (DOUT), D26.4 (DIN)
unnamed: D26.2 (DOUT), D27.4 (DIN)
unnamed: D27.2 (DOUT), D28.4 (DIN)
unnamed: D28.2 (DOUT), D29.4 (DIN)
unnamed: D29.2 (DOUT), D30.4 (DIN)
unnamed: D30.2 (DOUT), D31.4 (DIN)
unnamed: D31.2 (DOUT), D32.4 (DIN)
unnamed: D32.2 (DOUT), D33.4 (DIN)
unnamed: Q3.1 (B), R30.1
unnamed: Q4.1 (B), R31.1

Notes on the sheet:
Mounting Holes
Test Point
Status LED
Activetion Status LED
POWER OUTLET
Motor Driver
UART
Boot and Enable
5way-Tracing
I2C

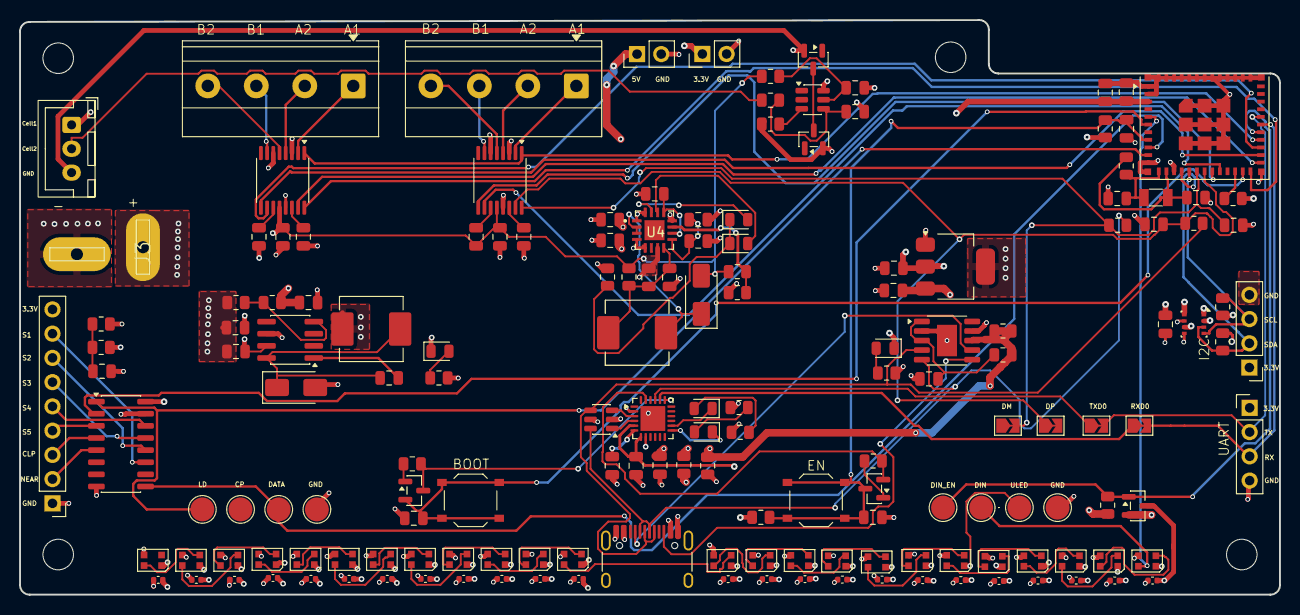
[picture p43: board robot.kicad_pcb from above]

Board: 4 copper layers, 132.0 x 60.2 mm, 170 parts (0 on the bottom side), 107 nets.
