malik019/iot-project/(commit log)

2026-05-25 Add gerber file
    [robot-B_Cu.gbr, robot-B_Mask.gbr, robot-B_Paste.gbr, robot-B_Silkscreen.gbr, robot-Edge_Cuts.gbr, robot-F_Cu.gbr, robot-F_Mask.gbr, robot-F_Paste.gbr]
2026-05-25 Update gerber file
    [robot-B_Cu.gbr, robot-B_Mask.gbr, robot-B_Paste.gbr, robot-B_Silkscreen.gbr, robot-Edge_Cuts.gbr, robot-F_Cu.gbr, robot-F_Mask.gbr, robot-F_Paste.gbr]
2026-05-28 Refine PCB layout: shift status LED for better visibility
    [robot-B_Cu.gbr, robot-B_Mask.gbr, robot-B_Paste.gbr, robot-B_Silkscreen.gbr, robot-Edge_Cuts.gbr, robot-F_Cu.gbr, robot-F_Mask.gbr, robot-F_Paste.gbr]
2026-06-10 chore: add gitignore for KiCad and Office lock files
